NTkot/speaker_amp_pcb/speaker_amp2.kicad_pcb

## KiCad design speaker_amp2.kicad_pcb (2025-02-26)

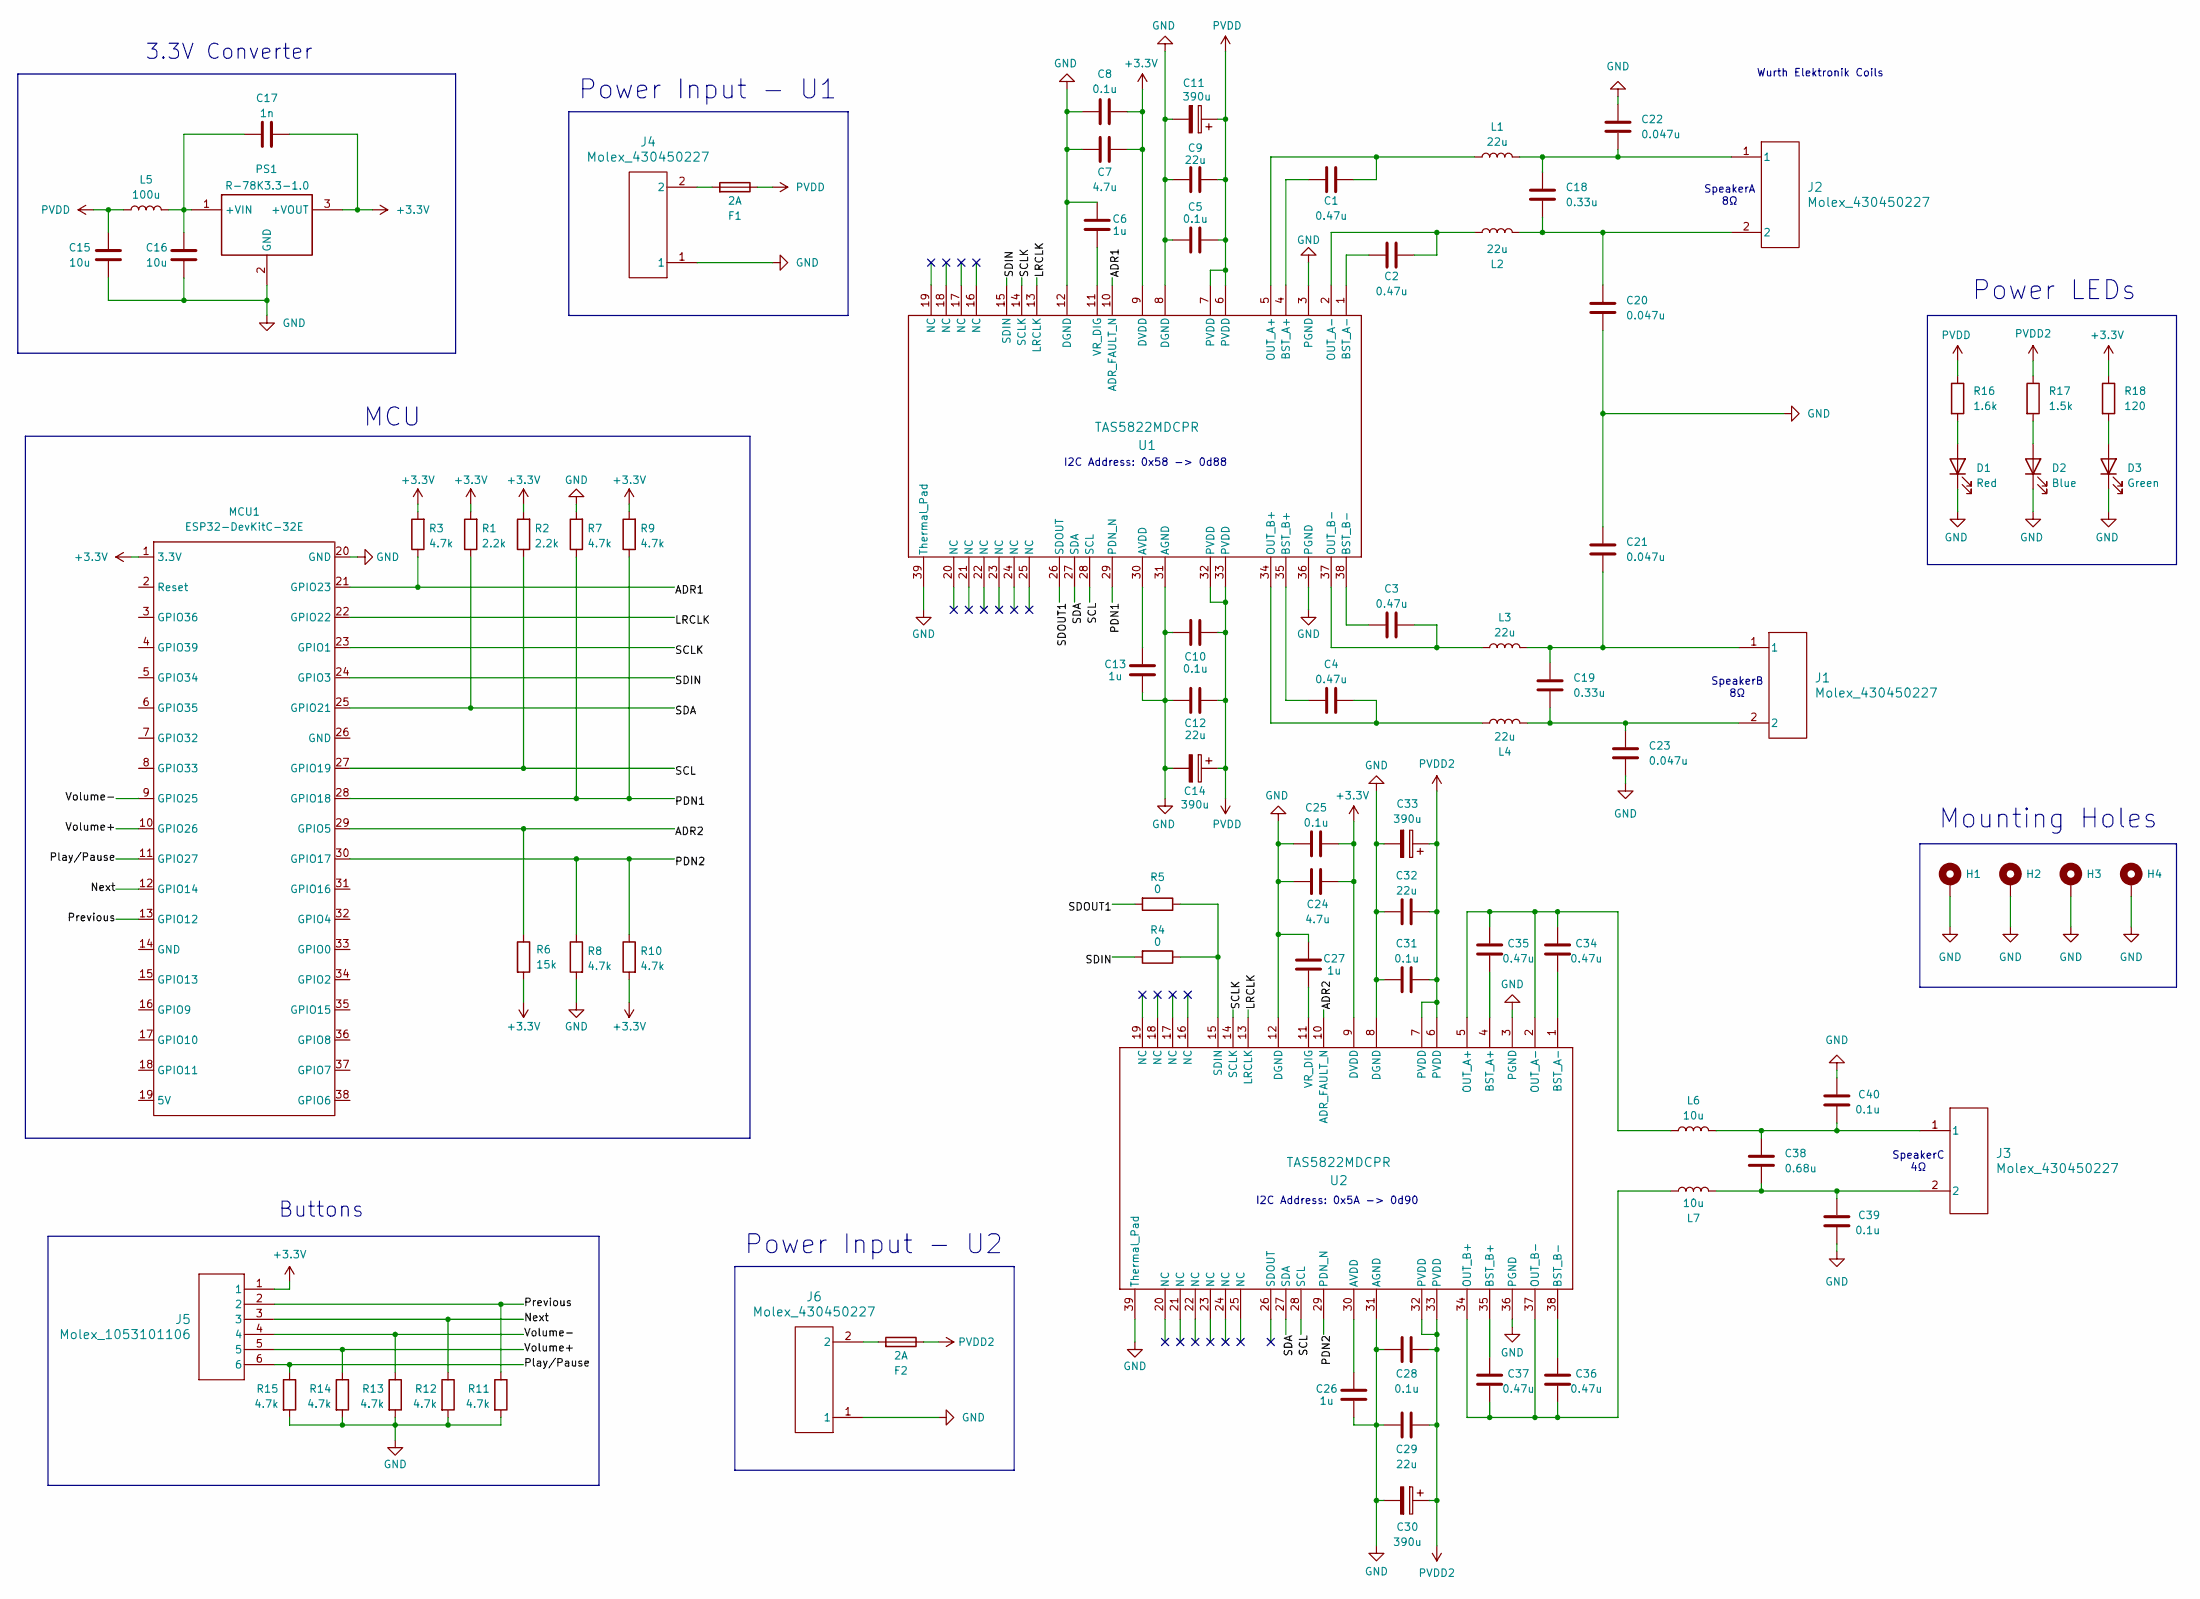
[picture p1: schematic speaker_amp2.kicad_sch]

Parts:
C1, C2, C3, C4, C34, C35, C36, C37: 0.47u; C_0603_1608Metric_Pad1.08x0.95mm_HandSolder
C5, C8, C10, C25, C28, C31: 0.1u; C_0603_1608Metric_Pad1.08x0.95mm_HandSolder
C6, C13, C26, C27: 1u; C_0603_1608Metric_Pad1.08x0.95mm_HandSolder
C7, C24: 4.7u; C_0805_2012Metric_Pad1.18x1.45mm_HandSolder
C9, C12, C29, C32: 22u; C_0805_2012Metric_Pad1.18x1.45mm_HandSolder
C11, C14, C30, C33: 390u; CP_Radial_D8.0mm_P3.50mm
C15, C16: 10u; C_0805_2012Metric_Pad1.18x1.45mm_HandSolder
C17: 1n; C_0805_2012Metric_Pad1.18x1.45mm_HandSolder
C18, C19: 0.33u; C_2824
C20, C21, C22, C23: 0.047u; C_2220_5750Metric_Pad1.97x5.40mm_HandSolder
C38: 0.68u; C_2220_5750Metric_Pad1.97x5.40mm_HandSolder
C39, C40: 0.1u; C_2220_5750Metric_Pad1.97x5.40mm_HandSolder
D1: Red; LED_PLCC-2_3.4x3.0mm_KA
D2: Blue; LED_PLCC-2_3.4x3.0mm_KA
D3: Green; LED_PLCC-2_3.4x3.0mm_KA
F1, F2: 2A; Fuse_1206_3216Metric
H1, H2, H3, H4: MountingHole_Pad; MountingHole_3.2mm_M3_DIN965_Pad_TopBottom
J1, J2, J3, J4, J6: Molex_430450227; 430450227_MOLEX
J5: Molex_1053101106
L1, L2, L3, L4: 22u; WE_7447773220
L5: 100u; RLS186
L6, L7: 10u; L_Wuerth_WE-PDF_Handsoldering_7mm_apart
MCU1: ESP32-DevKitC-32E
PS1: R-78K3.3-1.0; R78K3310
R1, R2: 2.2k; R_0805_2012Metric_Pad1.20x1.40mm_HandSolder
R3, R7, R8, R9, R10, R11, R12, R13, R14, R15: 4.7k; R_0805_2012Metric_Pad1.20x1.40mm_HandSolder
R4, R5: 0; R_0805_2012Metric_Pad1.20x1.40mm_HandSolder
R6: 15k; R_0805_2012Metric_Pad1.20x1.40mm_HandSolder
R16: 1.6k; R_0805_2012Metric_Pad1.20x1.40mm_HandSolder
R17: 1.5k; R_0805_2012Metric_Pad1.20x1.40mm_HandSolder
R18: 120; R_0805_2012Metric_Pad1.20x1.40mm_HandSolder
U1, U2: TAS5822MDCPR; DCP0038A-IPC_C

Connections:
+3.3V: C7.1, C8.1, C17.1, C24.2, C25.1, J5.1, MCU1.1 (3.3V), PS1.3 (+VOUT), R1.2, R2.2, R3.2, R6.2, R9.2, R10.2, R18.1, U1.9 (DVDD), U2.9 (DVDD)
/ADR1: MCU1.21 (GPIO23), R3.1, U1.10 (ADR_FAULT_N)
/ADR2: MCU1.29 (GPIO5), R6.1, U2.10 (ADR_FAULT_N)
/LRCLK: MCU1.22 (GPIO22), U1.13 (LRCLK), U2.13 (LRCLK)
/Next: J5.3, MCU1.12 (GPIO14), R12.1
/PDN1: MCU1.28 (GPIO18), R7.1, R9.1, U1.29 (PDN_N)
/PDN2: MCU1.30 (GPIO17), R8.1, R10.1, U2.29 (PDN_N)
/Play/Pause: J5.6, MCU1.11 (GPIO27), R15.1
/Previous: J5.2, MCU1.13 (GPIO12), R11.1
/SCL: MCU1.27 (GPIO19), R2.1, U1.28 (SCL), U2.28 (SCL)
/SCLK: MCU1.23 (GPIO1), U1.14 (SCLK), U2.14 (SCLK)
/SDA: MCU1.25 (GPIO21), R1.1, U1.27 (SDA), U2.27 (SDA)
/SDIN: MCU1.24 (GPIO3), R4.2, U1.15 (SDIN)
/SDOUT1: R5.2, U1.26 (SDOUT)
/Volume+: J5.5, MCU1.10 (GPIO26), R14.1
/Volume-: J5.4, MCU1.9 (GPIO25), R13.1
GND: C5.1, C6.2, C7.2, C8.2, C9.1, C10.1, C11.2, C12.1, C13.1, C14.2, C15.1, C16.1, C20.2, C21.1, C22.1, C23.2, C24.1, C25.2, C26.1, C27.1, C28.2, C29.2, C30.2, C31.2, C32.2, C33.2, C39.1, C40.2, D1.1 (K), D2.1 (K), D3.1 (K), H1.1, H2.1, H3.1, H4.1, J4.1, J6.1, MCU1.20 (GND), PS1.2 (GND), R7.2, R8.2, R11.2, R12.2, R13.2, R14.2, R15.2, U1.3 (PGND), U1.8 (DGND), U1.12 (DGND), U1.31 (AGND), U1.36 (PGND), U1.39 (Thermal_Pad), U2.3 (PGND), U2.8 (DGND), U2.12 (DGND), U2.31 (AGND), U2.36 (PGND), U2.39 (Thermal_Pad)
unnamed: C18.1, C22.2, J2.1, L1.2
unnamed: C18.2, C20.1, J2.2, L2.2
unnamed: C19.1, C21.2, J1.1, L3.2
unnamed: C19.2, C23.1, J1.2, L4.2
unnamed: C38.1, C40.1, J3.1, L6.2
unnamed: C38.2, C39.2, J3.2, L7.2
unnamed: D1.2 (A), R16.2
unnamed: D2.2 (A), R17.2
unnamed: D3.2 (A), R18.2
unnamed: F1.2, J4.2
unnamed: F2.2, J6.2
unnamed: C16.2, C17.2, L5.2, PS1.1 (+VIN)
unnamed: C13.2, U1.30 (AVDD)
unnamed: C1.1, U1.4 (BST_A+)
unnamed: C2.1, U1.1 (BST_A-)
unnamed: C4.1, U1.35 (BST_B+)
unnamed: C3.1, U1.38 (BST_B-)
unnamed: C1.2, L1.1, U1.5 (OUT_A+)
unnamed: C2.2, L2.1, U1.2 (OUT_A-)
unnamed: C4.2, L4.1, U1.34 (OUT_B+)
unnamed: C3.2, L3.1, U1.37 (OUT_B-)
unnamed: C6.1, U1.11 (VR_DIG)
unnamed: C26.2, U2.30 (AVDD)
unnamed: C35.1, U2.4 (BST_A+)
unnamed: C34.1, U2.1 (BST_A-)
unnamed: C37.2, U2.35 (BST_B+)
unnamed: C36.2, U2.38 (BST_B-)
unnamed: C34.2, C35.2, L6.1, U2.2 (OUT_A-), U2.5 (OUT_A+)
unnamed: C36.1, C37.1, L7.1, U2.34 (OUT_B+), U2.37 (OUT_B-)
unnamed: R4.1, R5.1, U2.15 (SDIN)
unnamed: C27.2, U2.11 (VR_DIG)
PVDD: C5.2, C9.2, C10.2, C11.1, C12.2, C14.1, C15.2, F1.1, L5.1, R16.1, U1.6 (PVDD), U1.7 (PVDD), U1.32 (PVDD), U1.33 (PVDD)
PVDD2: C28.1, C29.1, C30.1, C31.1, C32.1, C33.1, F2.1, R17.1, U2.6 (PVDD), U2.7 (PVDD), U2.32 (PVDD), U2.33 (PVDD)

Notes on the sheet:
Wurth Elektronik Coils
Power Input - U2
MCU
SpeakerC 4Ω
SpeakerA 8Ω
I2C Address: 0x58 -> 0d88
I2C Address: 0x5A -> 0d90
Power LEDs
SpeakerB 8Ω
Buttons
Mounting Holes
3.3V Converter
Power Input - U1

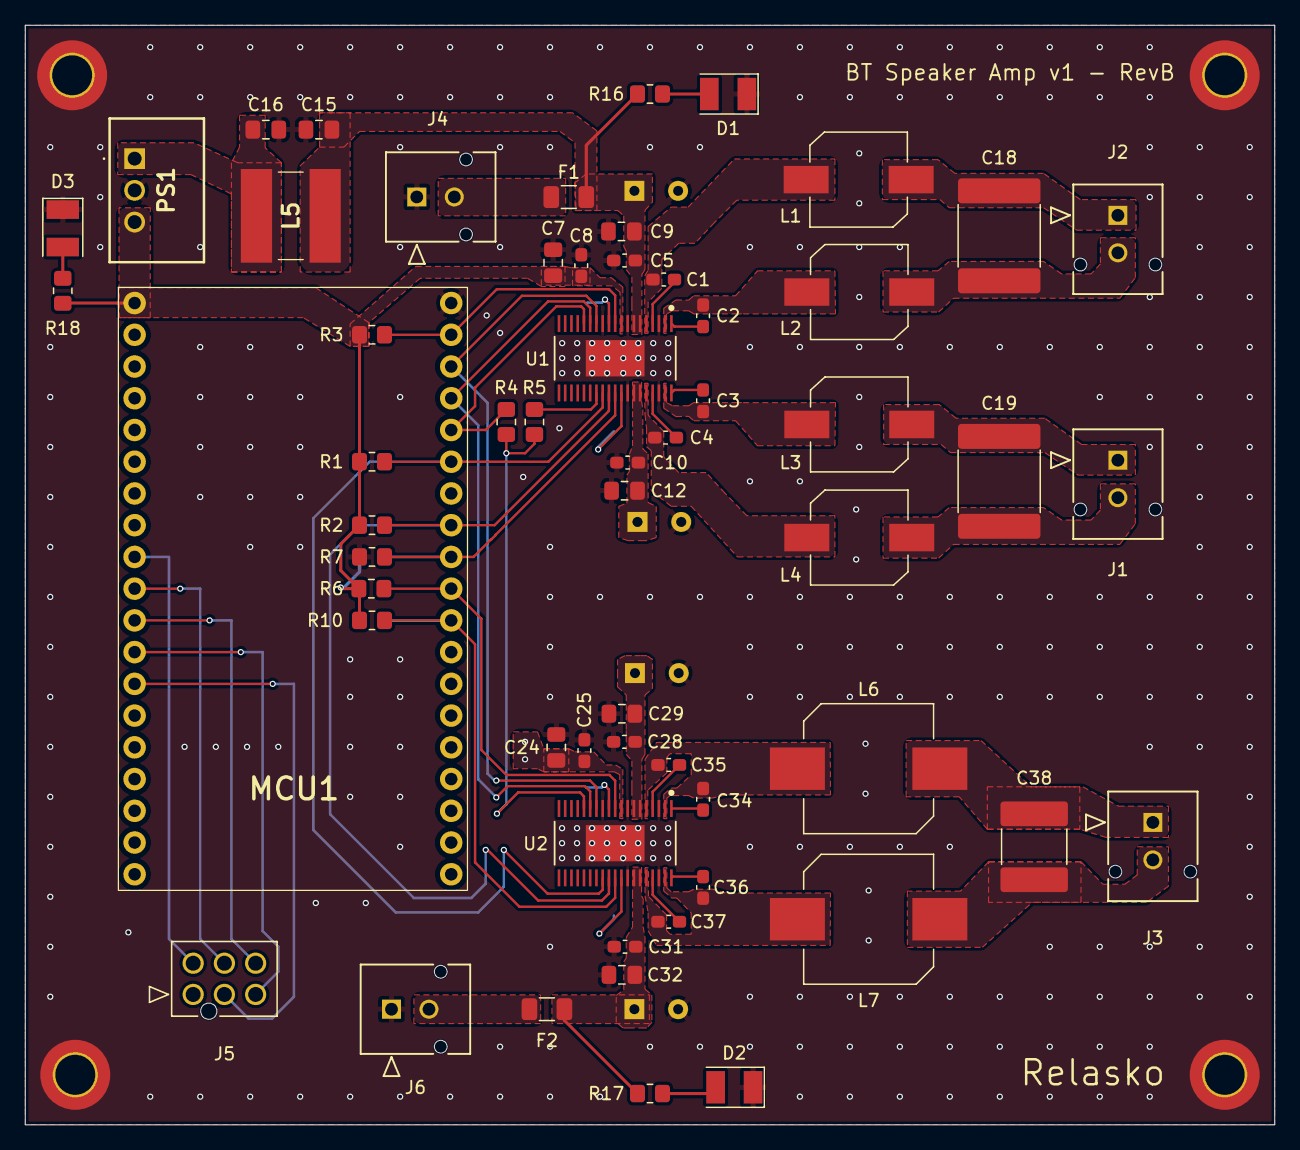
[picture p2: board speaker_amp2.kicad_pcb from above]

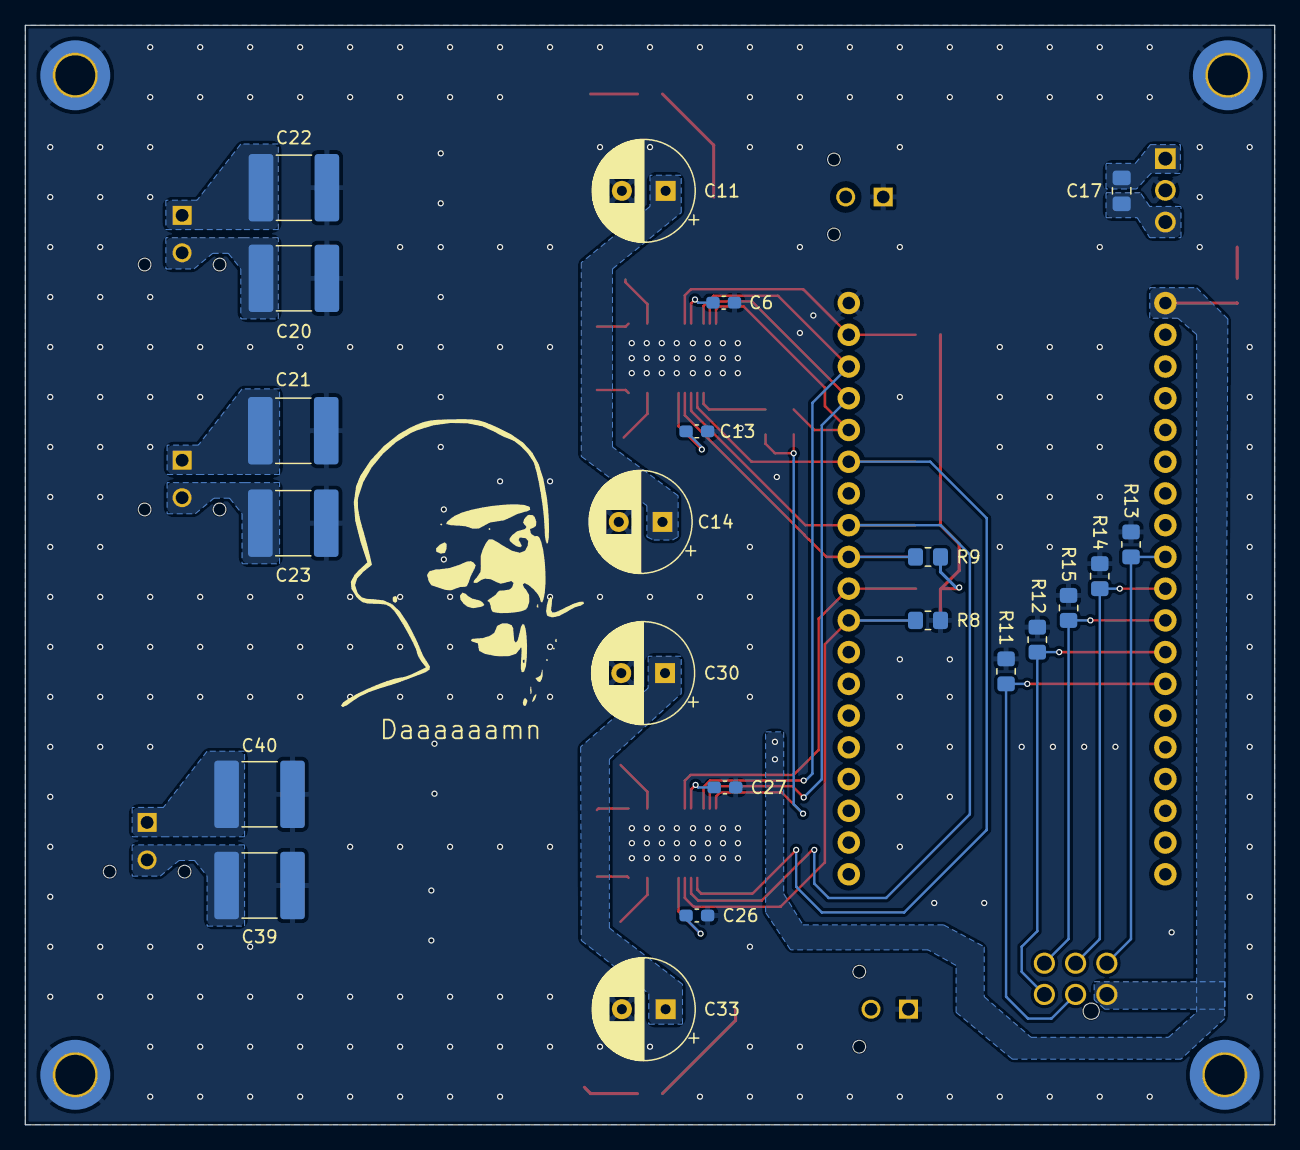
[picture p3: board speaker_amp2.kicad_pcb from below]

Board: 2 copper layers, 100.0 x 88.0 mm, 84 parts (22 on the bottom side), 50 nets.
