NTkot/speaker_amp_pcb/(commit log)

2024-09-23 refactored repo
    [speaker_amp2.kicad_pcb, speaker_amp2.kicad_sch]
2024-09-23 added mcu to schematic
    [speaker_amp2.kicad_sch]
2024-09-24 added class D amp and datasheets, added most capacitors to schematic
    [speaker_amp2.kicad_sch]
2024-09-25 added dcdc converter
    [speaker_amp2.kicad_sch]
2024-09-26 finalized logic level dcdc converter
    [speaker_amp2.kicad_sch]
2024-10-05 added new ESP32 footprint lib
2024-10-05 replaced ESP32-C6 with ESP32-WROOM-32E
    [speaker_amp2.kicad_sch]
2024-10-06 added communication wires with amp
    [speaker_amp2.kicad_sch]
2024-10-06 lc filter design work
2024-10-09 added C_BTL capacitor
    [speaker_amp2.kicad_sch]
2024-10-09 added C_g cap
    [speaker_amp2.kicad_sch]
2024-10-13 added 2nd TAS5822M
    [speaker_amp2.kicad_sch]
2024-10-15 added mono ch bootstrap caps
    [speaker_amp2.kicad_sch]
2024-10-16 finished first iteration, connectors wip
    [speaker_amp2.kicad_sch]
2024-10-19 added connectors
    [speaker_amp2.kicad_sch]
2024-10-20 changes after reviewing schematic
    [speaker_amp2.kicad_sch]
2024-12-01 added button connector
    [speaker_amp2.kicad_sch]
2024-12-01 fixed silkscreen on connector footprints
    [speaker_amp2.kicad_sch]
2024-12-03 finished schematic with speaker buttons
    [speaker_amp2.kicad_sch]
2024-12-05 added button connector to pcb
    [speaker_amp2.kicad_pcb, speaker_amp2.kicad_sch]
2024-12-05 placed 3.3V to pcb
    [speaker_amp2.kicad_pcb, speaker_amp2.kicad_sch]
2024-12-16 changed amplifiers in schematic to match PCB pins
    [speaker_amp2.kicad_pcb, speaker_amp2.kicad_sch]
2024-12-20 placed amp ics, did low-voltage connections
    [speaker_amp2.kicad_pcb, speaker_amp2.kicad_sch]
2025-01-12 changed some components (coils) for smaller ones
    [speaker_amp2.kicad_pcb, speaker_amp2.kicad_sch]
2025-01-14 changed output capacitors to smaller ones
    [speaker_amp2.kicad_pcb, speaker_amp2.kicad_sch]
2025-01-14 finalized pcb component placement; started connections
    [speaker_amp2.kicad_pcb, speaker_amp2.kicad_sch]
2025-01-17 started working on subwoofer amp traces
    [speaker_amp2.kicad_pcb, speaker_amp2.kicad_sch]
2025-01-18 first finalized pcb
    [speaker_amp2.kicad_pcb]
2025-01-21 added LEDs and mounting holes
    [speaker_amp2.kicad_pcb, speaker_amp2.kicad_sch]
2025-01-21 preparing heat vias for amps
    [speaker_amp2.kicad_pcb]
2025-01-21 Added array of thermal reliefs
    [speaker_amp2.kicad_pcb]
2025-01-26 final design + BoM
    [speaker_amp2.kicad_pcb, speaker_amp2.kicad_sch, speaker_amp2_BOM_part.csv]
2025-02-26 final design, sent for production
    [speaker_amp2-B_Cu.gbl, speaker_amp2-B_Mask.gbs, speaker_amp2-B_Paste.gbp, speaker_amp2-B_Silkscreen.gbo, speaker_amp2-Edge_Cuts.gm1, speaker_amp2-F_Cu.gtl, speaker_amp2-F_Mask.gts, speaker_amp2-F_Paste.gtp]
2025-03-04 added esp32 program to find addresses
2025-03-05 i2c addresses clarification
    [speaker_amp2.kicad_sch]
2025-05-23 removed pcb order files
    [speaker_amp2-B_Cu.gbl, speaker_amp2-B_Mask.gbs, speaker_amp2-B_Paste.gbp, speaker_amp2-B_Silkscreen.gbo, speaker_amp2-Edge_Cuts.gm1, speaker_amp2-F_Cu.gtl, speaker_amp2-F_Mask.gts, speaker_amp2-F_Paste.gtp]
2025-05-24 simplified arduino sketches
2025-05-24 added basic bt test sketch for esp32
